hotwolf/AriCalculator/Hardware/RevC/Keypad/KiCad/Keypad4.jpg

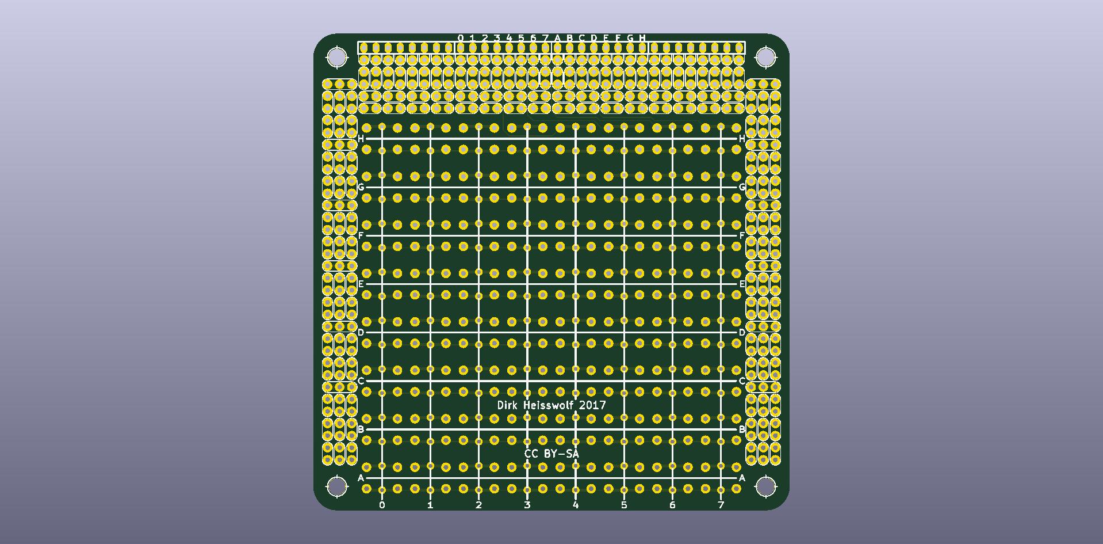
Hardware/RevC/Keypad/KiCad/Keypad4.jpg
