hotwolf/AriCalculator/Hardware/RevC/Keypad/KiCad/Keypad1.jpg

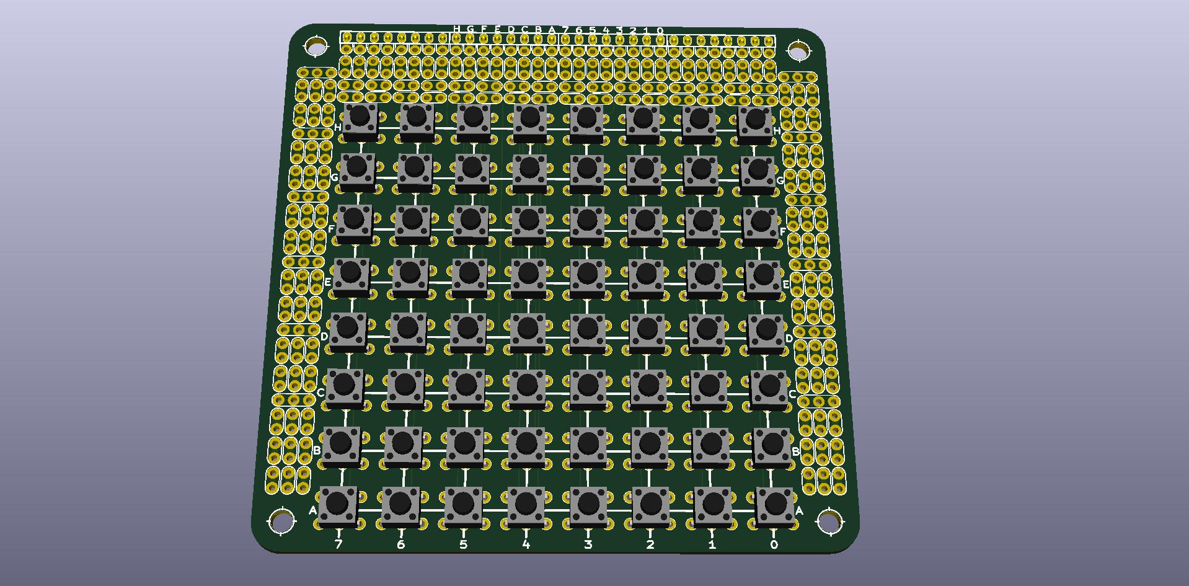
Hardware/RevC/Keypad/KiCad/Keypad1.jpg
