hotwolf/AriCalculator/Hardware/RevC/Keypad/KiCad/Keypad2.jpg

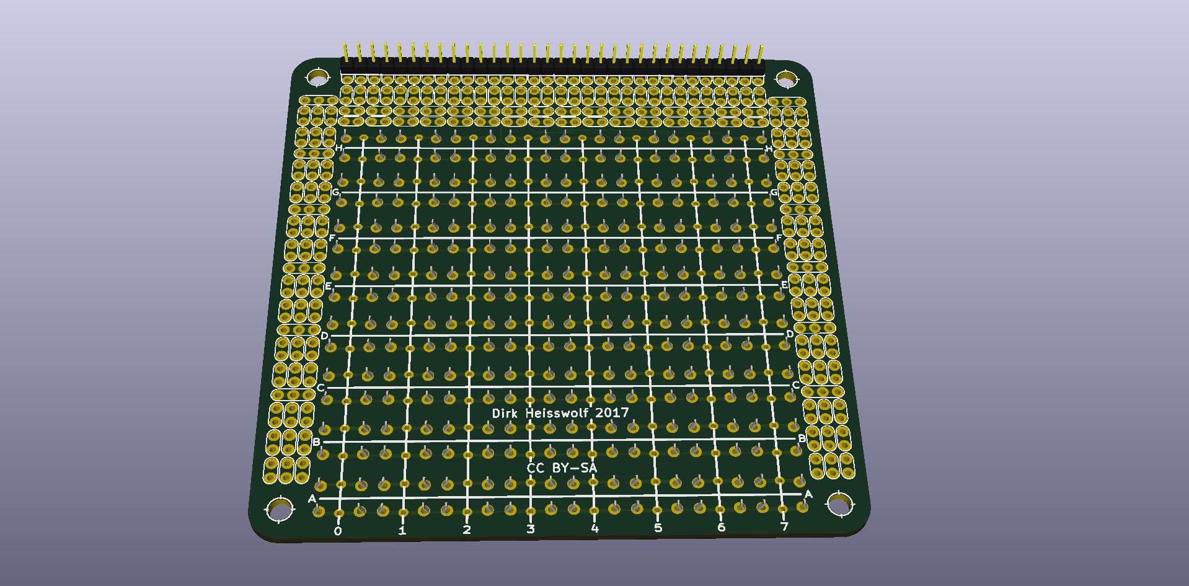
Hardware/RevC/Keypad/KiCad/Keypad2.jpg
