hotwolf/AriCalculator/(list of files, cad)

Other CAD files:
Hardware/RevC/Enclosure/case.scad
