hotwolf/AriCalculator/Hardware/RevC/PCB/AriCalculator-RevC Assembly Plan.pdf

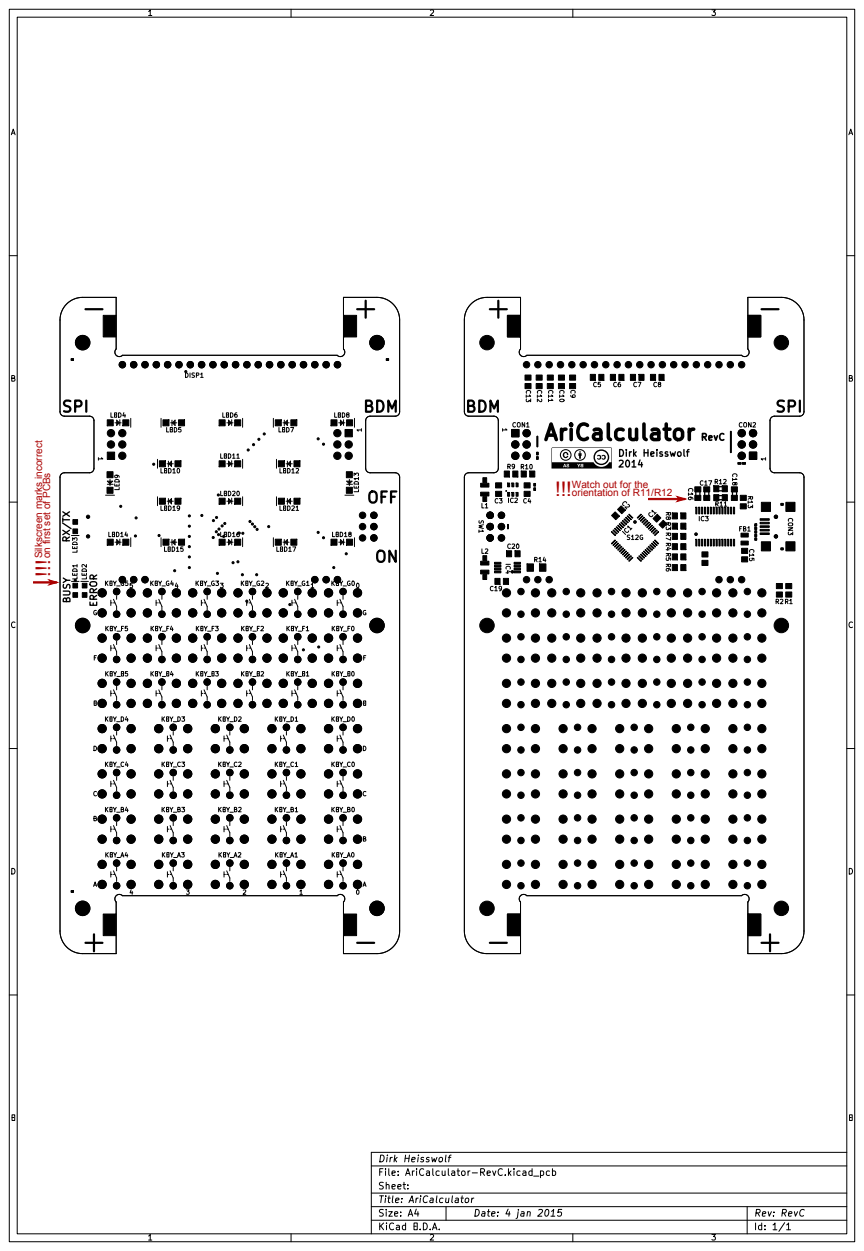
[picture p4: page 1]

Silkscreen marks incorrect

on first set of PCBs !!!

Watch out for the !!!orientation of R11/R12
