hotwolf/AriCalculator/Hardware/RevC/PCB/AriCalculator-RevC Schematic.pdf

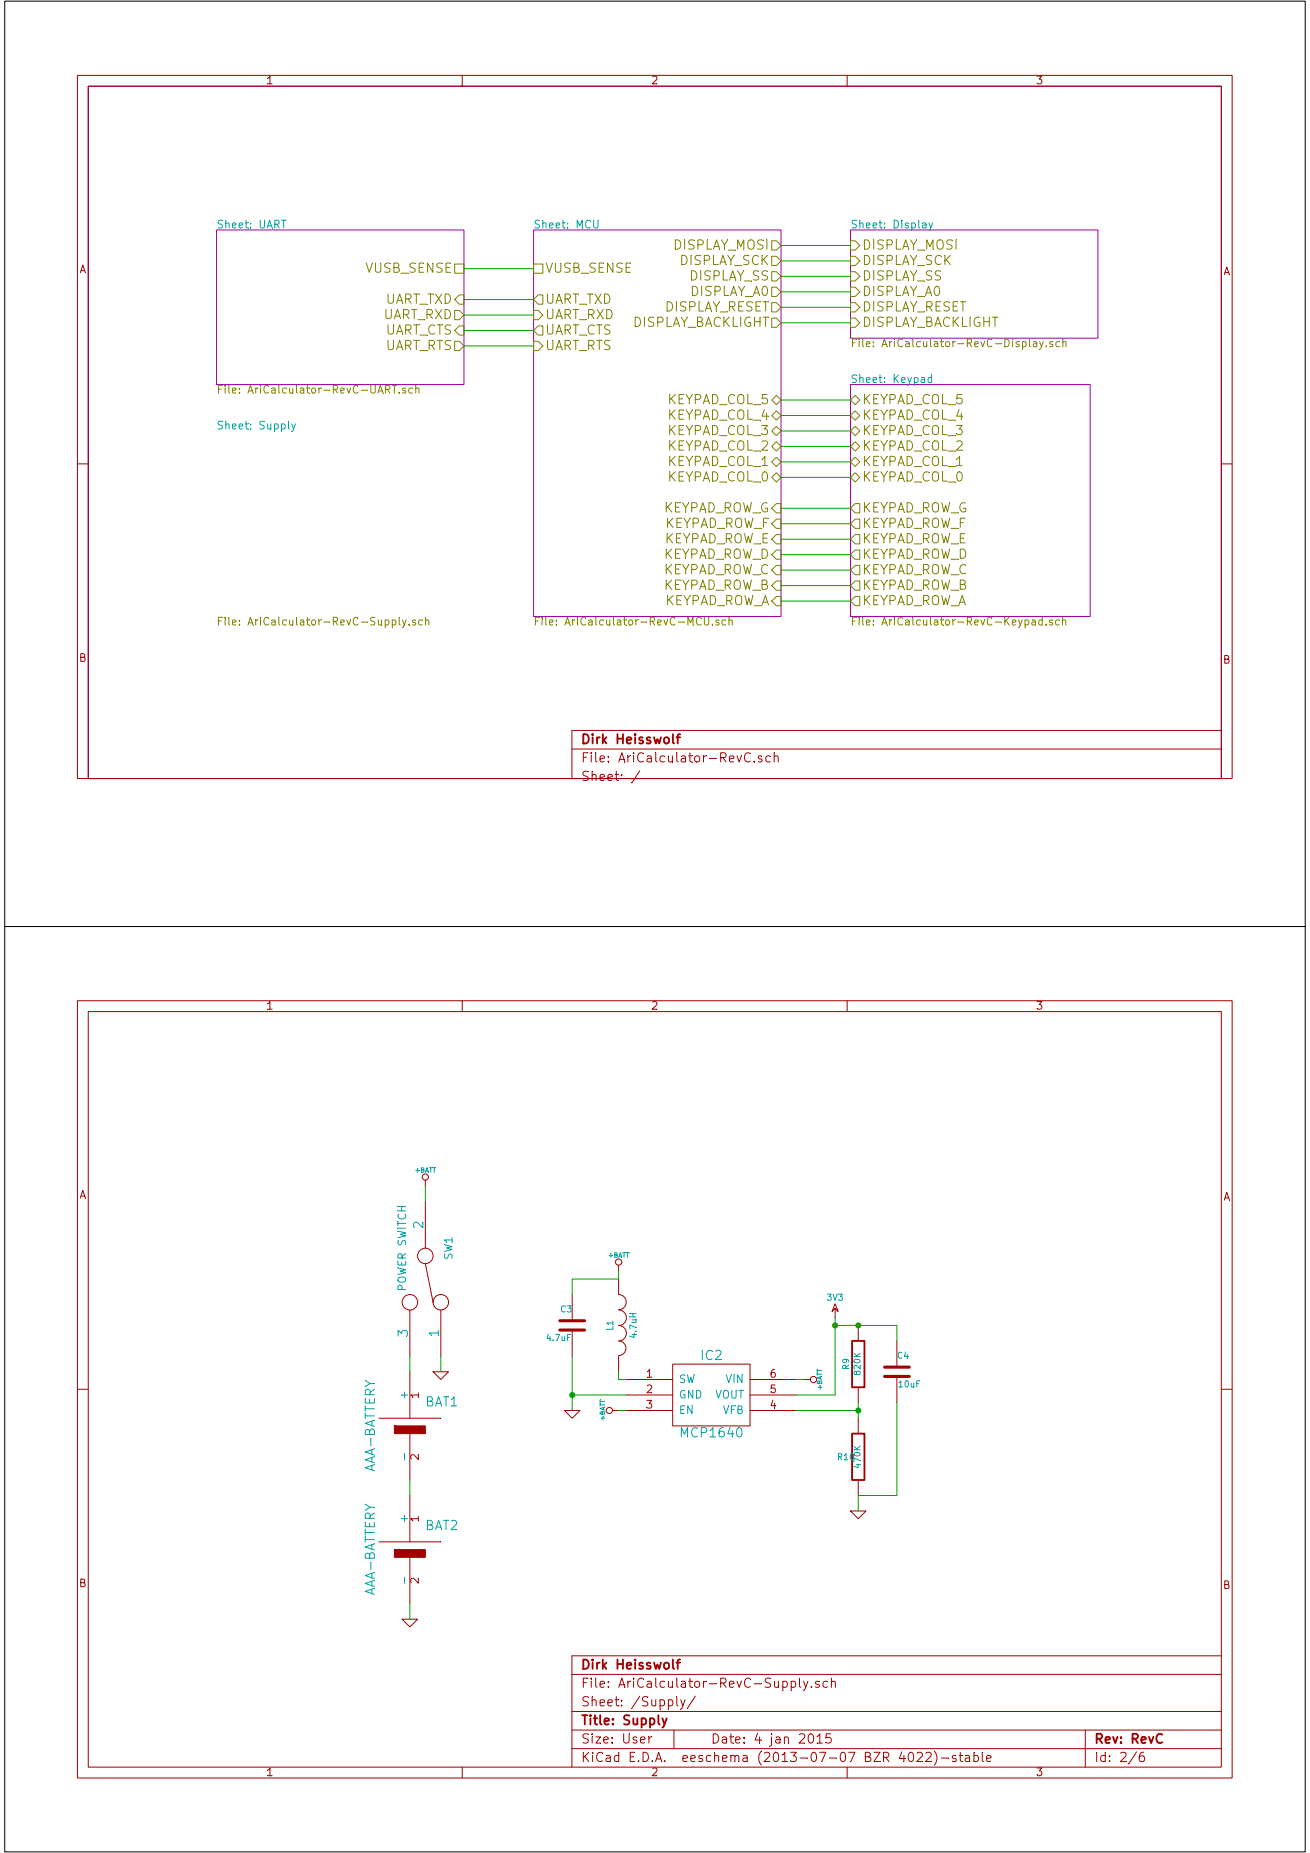
[picture p5: page 1]

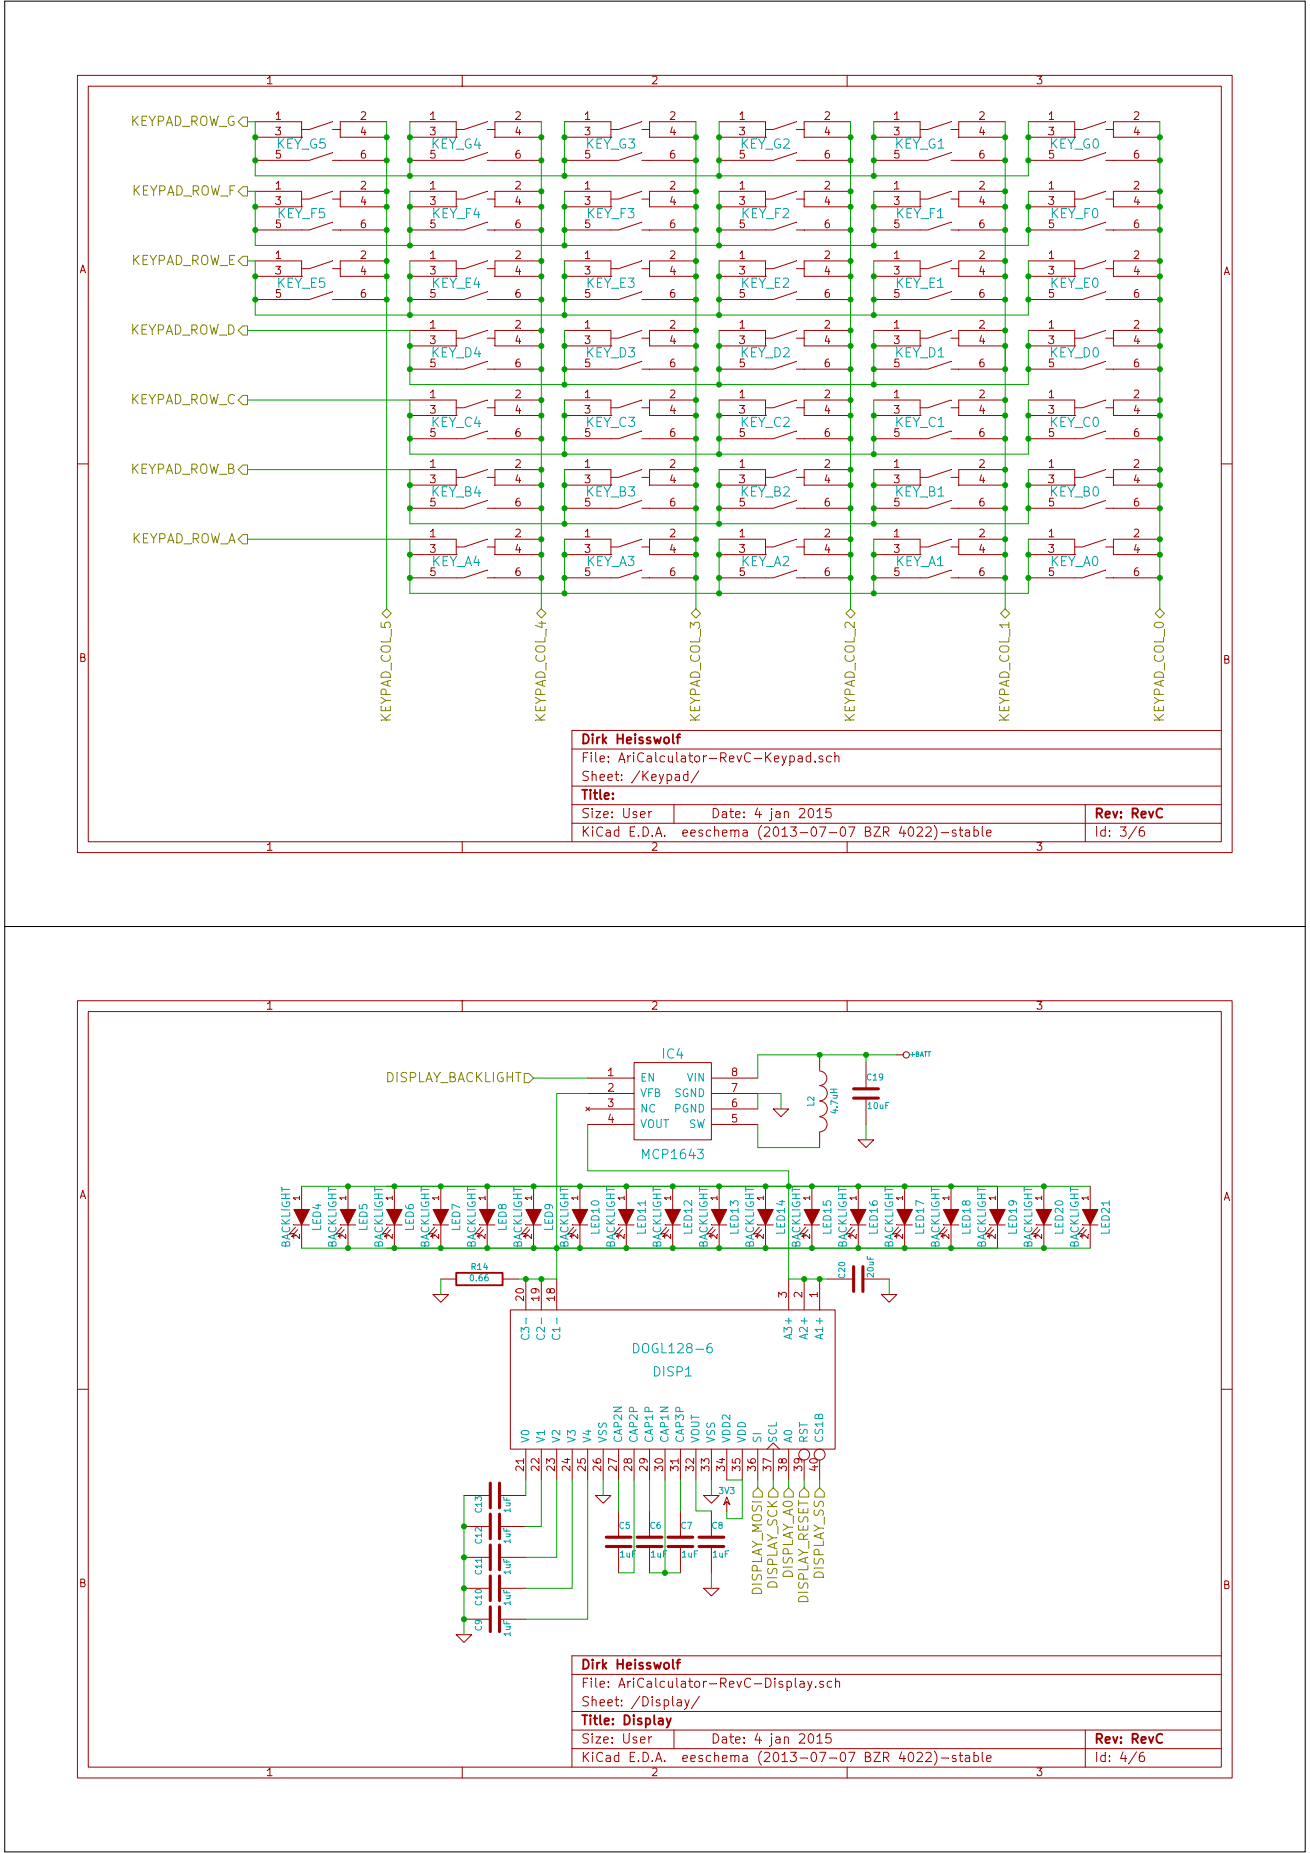
[picture p6: page 2]

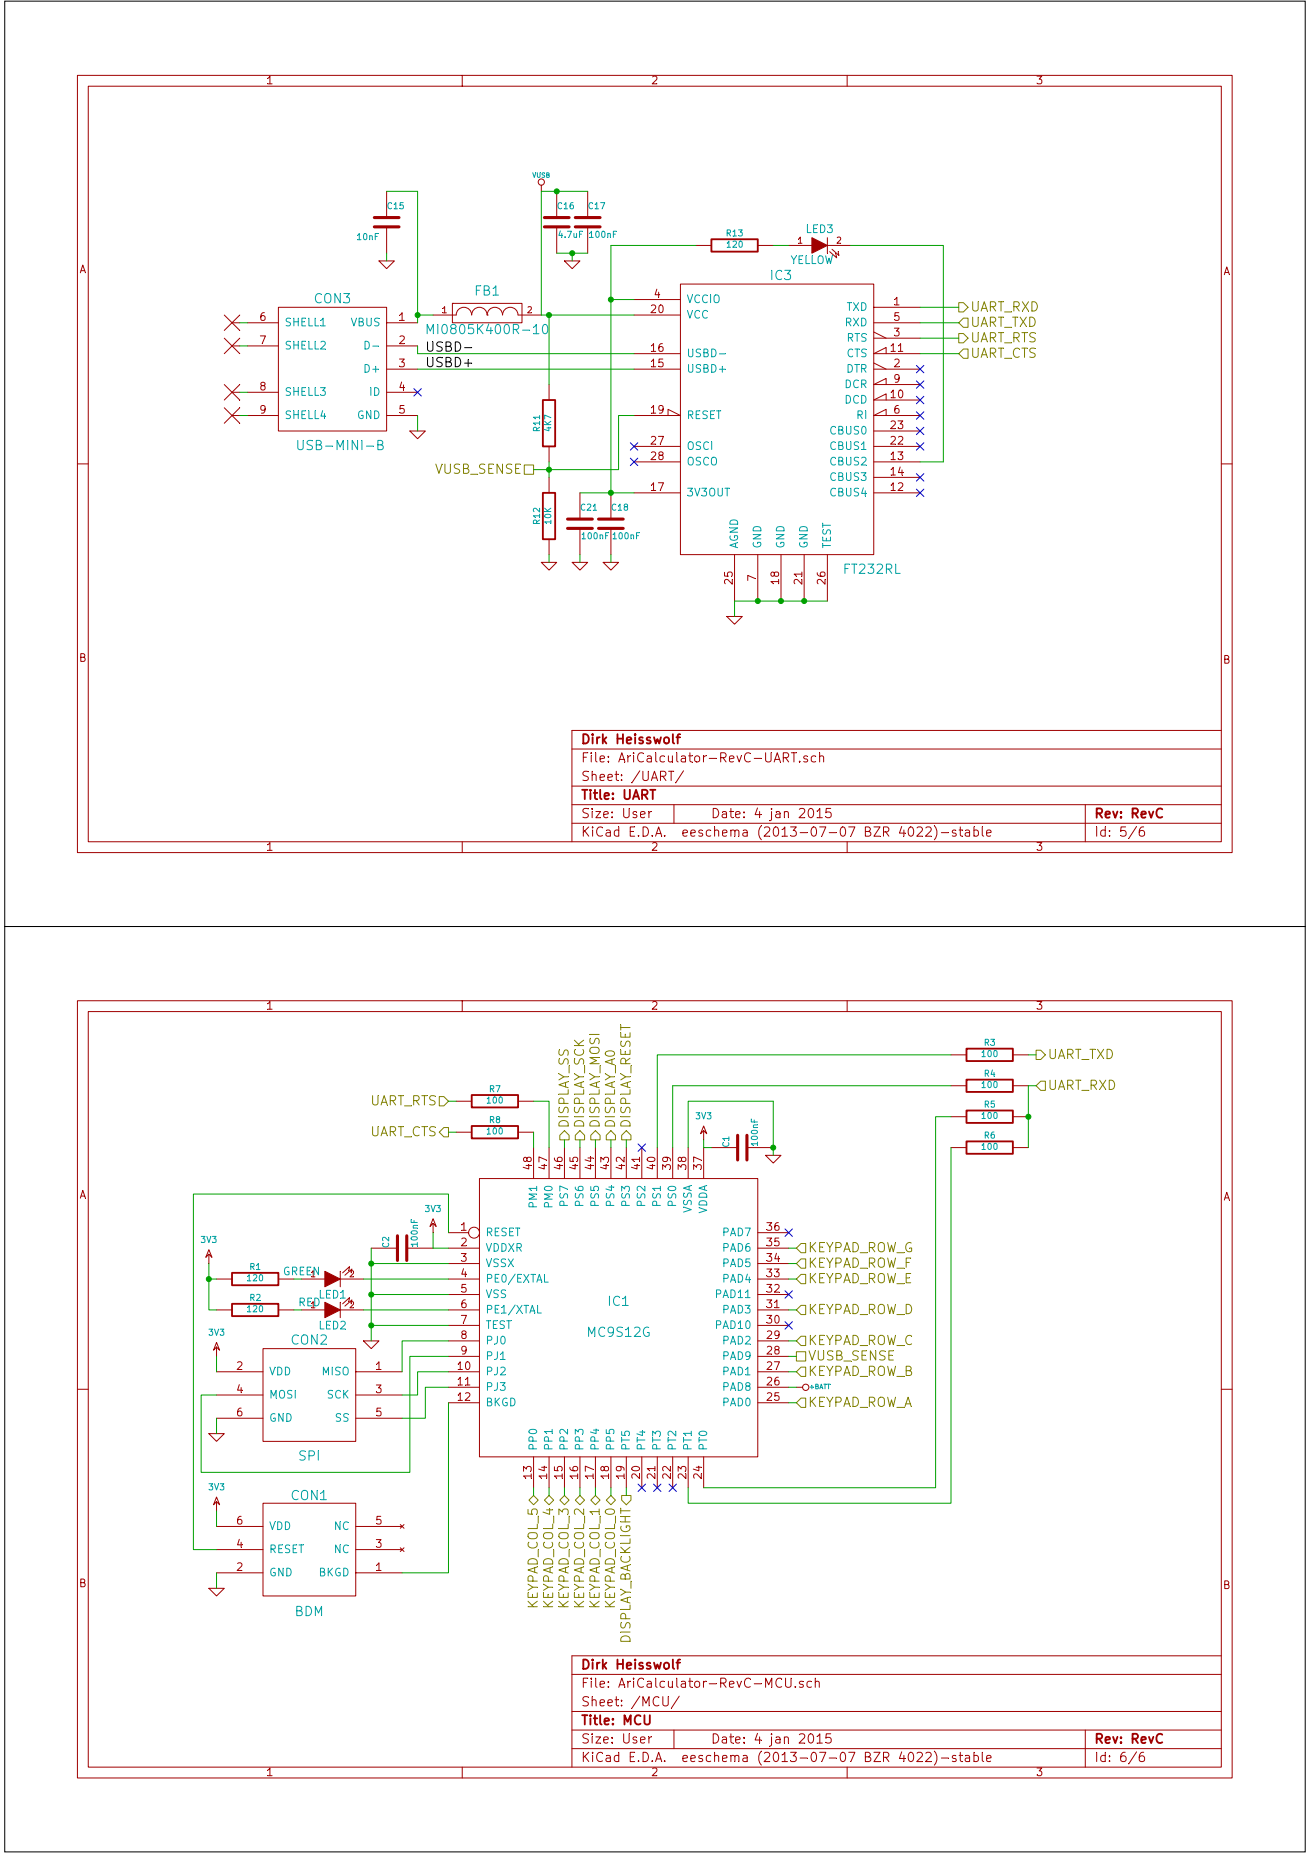
[picture p7: page 3]
