hotwolf/AriCalculator/Hardware/RevC/Enclosure/AriCalculator-RevC Laser Order - Dimensions.pdf

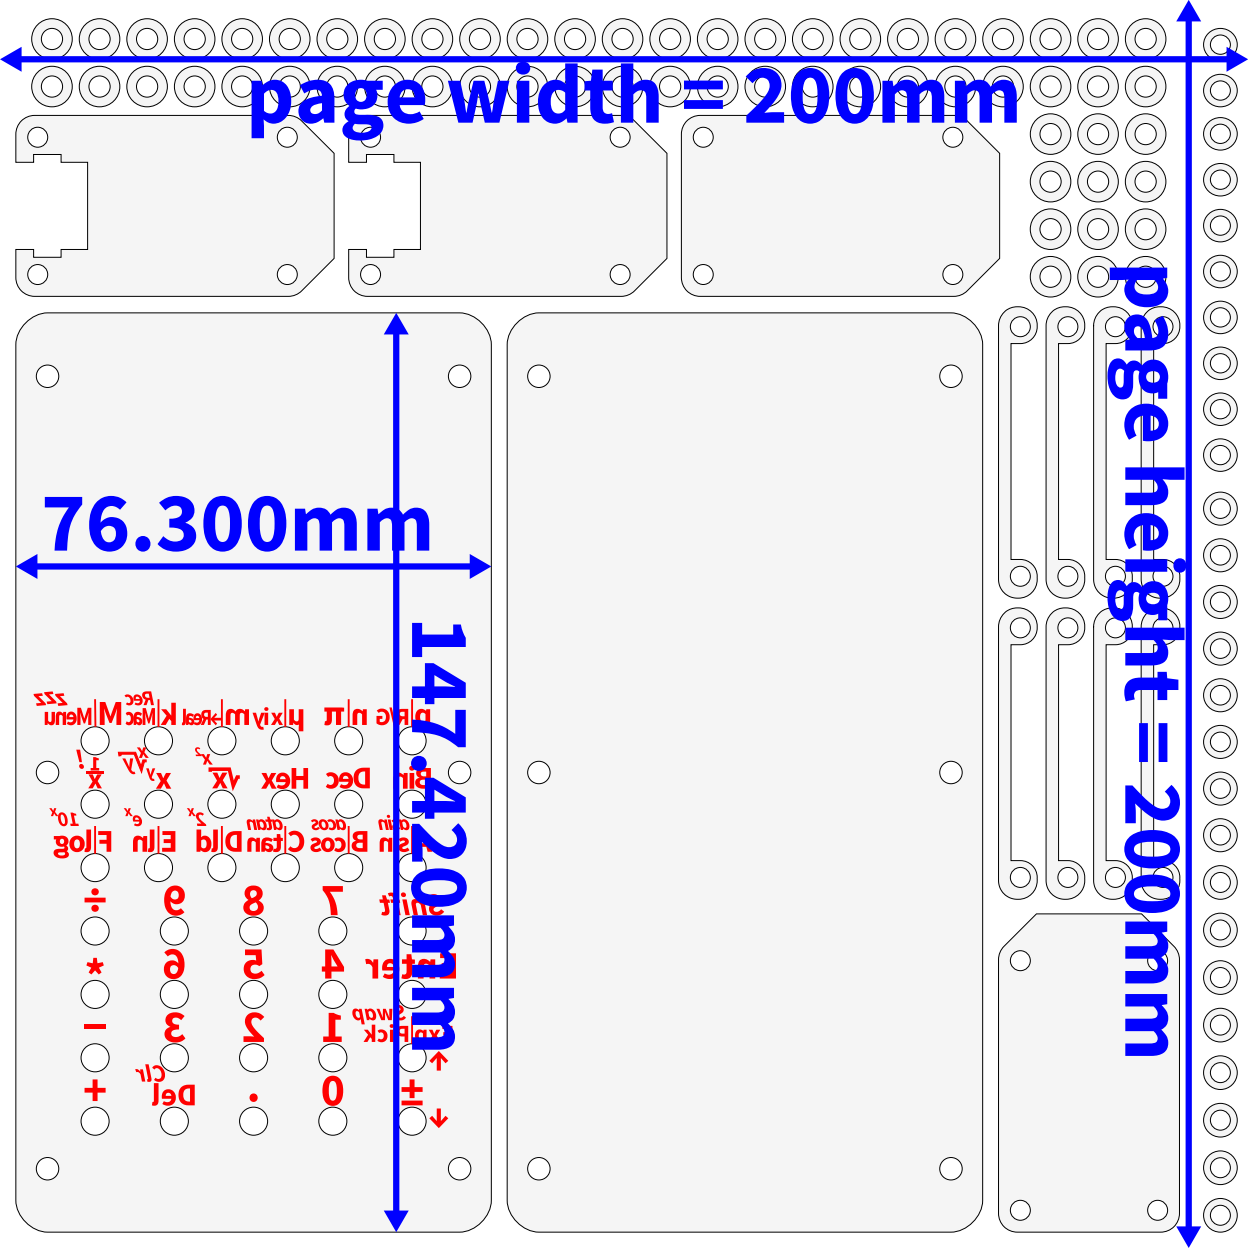
[picture p8: page 1]
