hotwolf/AriCalculator/Hardware/RevC/Keypad/KiCad/Keypad.kicad_pcb

## KiCad design Hardware/RevC/Keypad/KiCad/Keypad.kicad_pcb (2018-02-14)

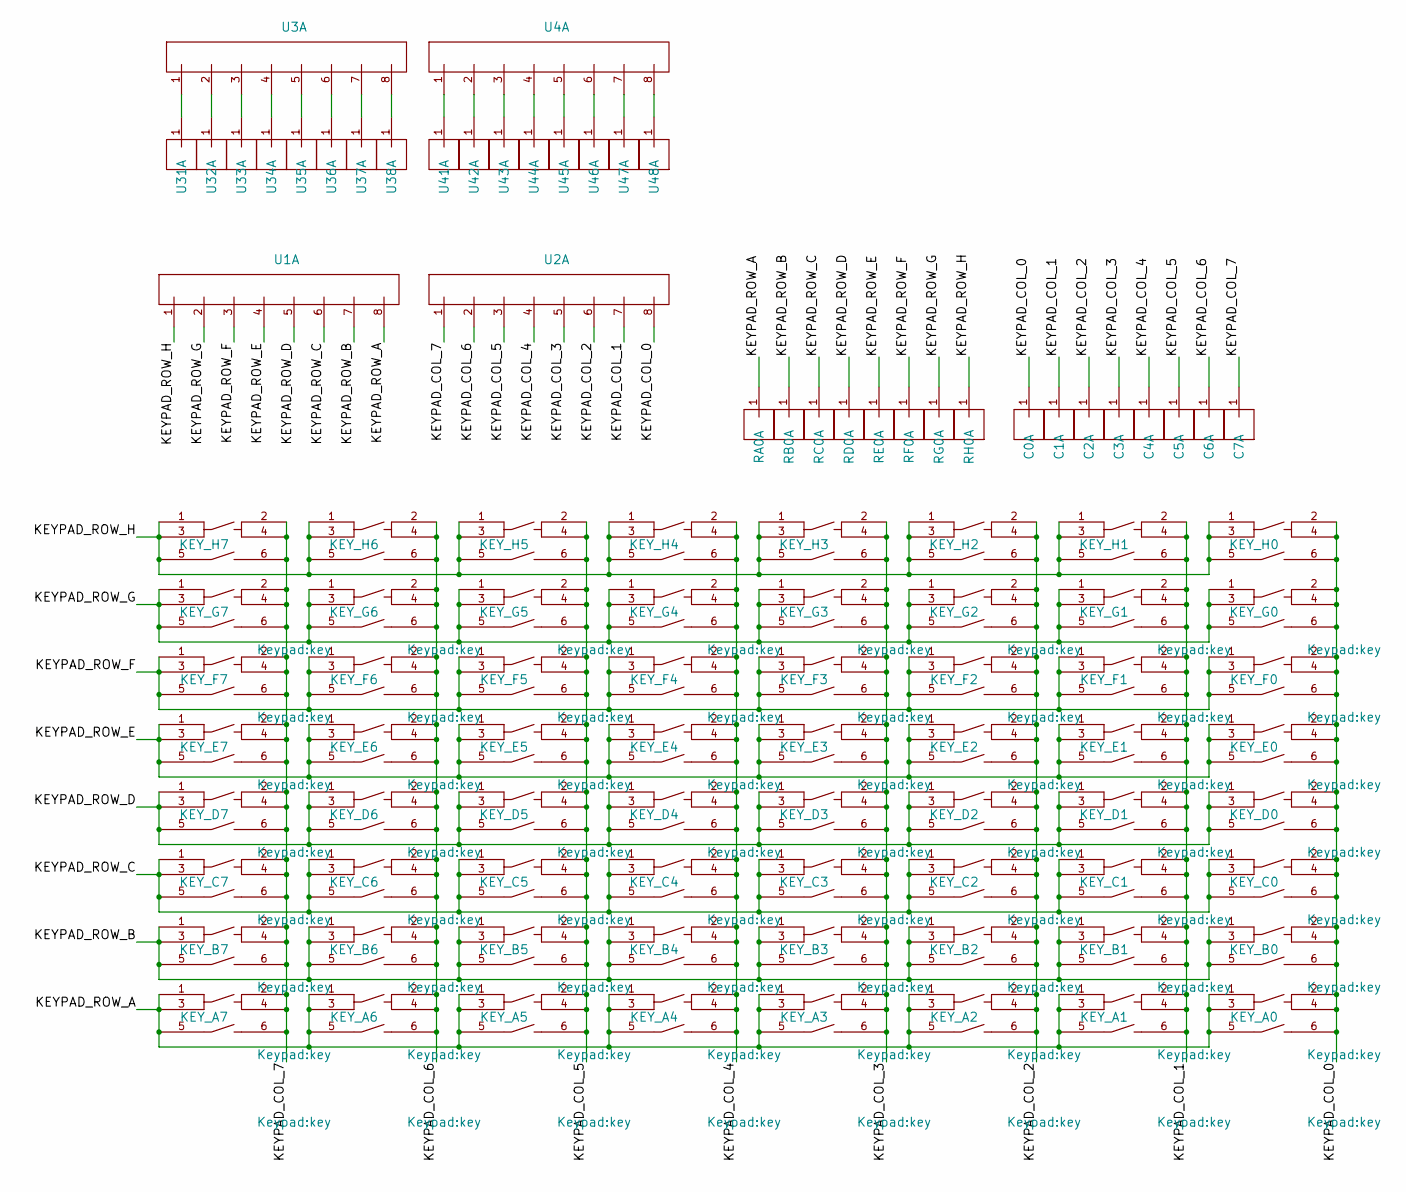
[picture p9: schematic Keypad.sch]

Parts:
C0, C1, C2, C3, C4, C5, C6, C7: PIN_STRIP_1; Connected_Pad
KEY_A0, KEY_A1, KEY_A2, KEY_A3, KEY_A4, KEY_A5, KEY_A6, KEY_A7: KEY; key
KEY_B0, KEY_B1, KEY_B2, KEY_B3, KEY_B4, KEY_B5, KEY_B6, KEY_B7: KEY; key
KEY_C0, KEY_C1, KEY_C2, KEY_C3, KEY_C4, KEY_C5, KEY_C6, KEY_C7: KEY; key
KEY_D0, KEY_D1, KEY_D2, KEY_D3, KEY_D4, KEY_D5, KEY_D6, KEY_D7: KEY; key
KEY_E0, KEY_E1, KEY_E2, KEY_E3, KEY_E4, KEY_E5, KEY_E6, KEY_E7: KEY; key
KEY_F0, KEY_F1, KEY_F2, KEY_F3, KEY_F4, KEY_F5, KEY_F6, KEY_F7: KEY; key
KEY_G0, KEY_G1, KEY_G2, KEY_G3, KEY_G4, KEY_G5, KEY_G6, KEY_G7: KEY; key
KEY_H0, KEY_H1, KEY_H2, KEY_H3, KEY_H4, KEY_H5, KEY_H6, KEY_H7: KEY; key
RA0: PIN_STRIP_1; Connected_Pad
RB0: PIN_STRIP_1; Connected_Pad
RC0: PIN_STRIP_1; Connected_Pad
RD0: PIN_STRIP_1; Connected_Pad
RE0: PIN_STRIP_1; Connected_Pad
RF0: PIN_STRIP_1; Connected_Pad
RG0: PIN_STRIP_1; Connected_Pad
RH0: PIN_STRIP_1; Connected_Pad
U1, U2, U3, U4: PIN_STRIP_8; pin_strip_8
U31, U32, U33, U34, U35, U36, U37, U38, U41, U42, U43, U44, U45, U46, U47, U48: PIN_STRIP_1; Connected_Pad

Connections:
/KEYPAD_COL_0: C0.1, KEY_A0.2, KEY_A0.4, KEY_A0.6, KEY_B0.2, KEY_B0.4, KEY_B0.6, KEY_C0.2, KEY_C0.4, KEY_C0.6, KEY_D0.2, KEY_D0.4, KEY_D0.6, KEY_E0.2, KEY_E0.4, KEY_E0.6, KEY_F0.2, KEY_F0.4, KEY_F0.6, KEY_G0.2, KEY_G0.4, KEY_G0.6, KEY_H0.2, KEY_H0.4, KEY_H0.6, U2.8
/KEYPAD_COL_1: C1.1, KEY_A1.2, KEY_A1.4, KEY_A1.6, KEY_B1.2, KEY_B1.4, KEY_B1.6, KEY_C1.2, KEY_C1.4, KEY_C1.6, KEY_D1.2, KEY_D1.4, KEY_D1.6, KEY_E1.2, KEY_E1.4, KEY_E1.6, KEY_F1.2, KEY_F1.4, KEY_F1.6, KEY_G1.2, KEY_G1.4, KEY_G1.6, KEY_H1.2, KEY_H1.4, KEY_H1.6, U2.7
/KEYPAD_COL_2: C2.1, KEY_A2.2, KEY_A2.4, KEY_A2.6, KEY_B2.2, KEY_B2.4, KEY_B2.6, KEY_C2.2, KEY_C2.4, KEY_C2.6, KEY_D2.2, KEY_D2.4, KEY_D2.6, KEY_E2.2, KEY_E2.4, KEY_E2.6, KEY_F2.2, KEY_F2.4, KEY_F2.6, KEY_G2.2, KEY_G2.4, KEY_G2.6, KEY_H2.2, KEY_H2.4, KEY_H2.6, U2.6
/KEYPAD_COL_3: C3.1, KEY_A3.2, KEY_A3.4, KEY_A3.6, KEY_B3.2, KEY_B3.4, KEY_B3.6, KEY_C3.2, KEY_C3.4, KEY_C3.6, KEY_D3.2, KEY_D3.4, KEY_D3.6, KEY_E3.2, KEY_E3.4, KEY_E3.6, KEY_F3.2, KEY_F3.4, KEY_F3.6, KEY_G3.2, KEY_G3.4, KEY_G3.6, KEY_H3.2, KEY_H3.4, KEY_H3.6, U2.5
/KEYPAD_COL_4: C4.1, KEY_A4.2, KEY_A4.4, KEY_A4.6, KEY_B4.2, KEY_B4.4, KEY_B4.6, KEY_C4.2, KEY_C4.4, KEY_C4.6, KEY_D4.2, KEY_D4.4, KEY_D4.6, KEY_E4.2, KEY_E4.4, KEY_E4.6, KEY_F4.2, KEY_F4.4, KEY_F4.6, KEY_G4.2, KEY_G4.4, KEY_G4.6, KEY_H4.2, KEY_H4.4, KEY_H4.6, U2.4
/KEYPAD_COL_5: C5.1, KEY_A5.2, KEY_A5.4, KEY_A5.6, KEY_B5.2, KEY_B5.4, KEY_B5.6, KEY_C5.2, KEY_C5.4, KEY_C5.6, KEY_D5.2, KEY_D5.4, KEY_D5.6, KEY_E5.2, KEY_E5.4, KEY_E5.6, KEY_F5.2, KEY_F5.4, KEY_F5.6, KEY_G5.2, KEY_G5.4, KEY_G5.6, KEY_H5.2, KEY_H5.4, KEY_H5.6, U2.3
/KEYPAD_COL_6: C6.1, KEY_A6.2, KEY_A6.4, KEY_A6.6, KEY_B6.2, KEY_B6.4, KEY_B6.6, KEY_C6.2, KEY_C6.4, KEY_C6.6, KEY_D6.2, KEY_D6.4, KEY_D6.6, KEY_E6.2, KEY_E6.4, KEY_E6.6, KEY_F6.2, KEY_F6.4, KEY_F6.6, KEY_G6.2, KEY_G6.4, KEY_G6.6, KEY_H6.2, KEY_H6.4, KEY_H6.6, U2.2
/KEYPAD_COL_7: C7.1, KEY_A7.2, KEY_A7.4, KEY_A7.6, KEY_B7.2, KEY_B7.4, KEY_B7.6, KEY_C7.2, KEY_C7.4, KEY_C7.6, KEY_D7.2, KEY_D7.4, KEY_D7.6, KEY_E7.2, KEY_E7.4, KEY_E7.6, KEY_F7.2, KEY_F7.4, KEY_F7.6, KEY_G7.2, KEY_G7.4, KEY_G7.6, KEY_H7.2, KEY_H7.4, KEY_H7.6, U2.1
/KEYPAD_ROW_A: KEY_A0.1, KEY_A0.3, KEY_A0.5, KEY_A1.1, KEY_A1.3, KEY_A1.5, KEY_A2.1, KEY_A2.3, KEY_A2.5, KEY_A3.1, KEY_A3.3, KEY_A3.5, KEY_A4.1, KEY_A4.3, KEY_A4.5, KEY_A5.1, KEY_A5.3, KEY_A5.5, KEY_A6.1, KEY_A6.3, KEY_A6.5, KEY_A7.1, KEY_A7.3, KEY_A7.5, RA0.1, U1.8
/KEYPAD_ROW_B: KEY_B0.1, KEY_B0.3, KEY_B0.5, KEY_B1.1, KEY_B1.3, KEY_B1.5, KEY_B2.1, KEY_B2.3, KEY_B2.5, KEY_B3.1, KEY_B3.3, KEY_B3.5, KEY_B4.1, KEY_B4.3, KEY_B4.5, KEY_B5.1, KEY_B5.3, KEY_B5.5, KEY_B6.1, KEY_B6.3, KEY_B6.5, KEY_B7.1, KEY_B7.3, KEY_B7.5, RB0.1, U1.7
/KEYPAD_ROW_C: KEY_C0.1, KEY_C0.3, KEY_C0.5, KEY_C1.1, KEY_C1.3, KEY_C1.5, KEY_C2.1, KEY_C2.3, KEY_C2.5, KEY_C3.1, KEY_C3.3, KEY_C3.5, KEY_C4.1, KEY_C4.3, KEY_C4.5, KEY_C5.1, KEY_C5.3, KEY_C5.5, KEY_C6.1, KEY_C6.3, KEY_C6.5, KEY_C7.1, KEY_C7.3, KEY_C7.5, RC0.1, U1.6
/KEYPAD_ROW_D: KEY_D0.1, KEY_D0.3, KEY_D0.5, KEY_D1.1, KEY_D1.3, KEY_D1.5, KEY_D2.1, KEY_D2.3, KEY_D2.5, KEY_D3.1, KEY_D3.3, KEY_D3.5, KEY_D4.1, KEY_D4.3, KEY_D4.5, KEY_D5.1, KEY_D5.3, KEY_D5.5, KEY_D6.1, KEY_D6.3, KEY_D6.5, KEY_D7.1, KEY_D7.3, KEY_D7.5, RD0.1, U1.5
/KEYPAD_ROW_E: KEY_E0.1, KEY_E0.3, KEY_E0.5, KEY_E1.1, KEY_E1.3, KEY_E1.5, KEY_E2.1, KEY_E2.3, KEY_E2.5, KEY_E3.1, KEY_E3.3, KEY_E3.5, KEY_E4.1, KEY_E4.3, KEY_E4.5, KEY_E5.1, KEY_E5.3, KEY_E5.5, KEY_E6.1, KEY_E6.3, KEY_E6.5, KEY_E7.1, KEY_E7.3, KEY_E7.5, RE0.1, U1.4
/KEYPAD_ROW_F: KEY_F0.1, KEY_F0.3, KEY_F0.5, KEY_F1.1, KEY_F1.3, KEY_F1.5, KEY_F2.1, KEY_F2.3, KEY_F2.5, KEY_F3.1, KEY_F3.3, KEY_F3.5, KEY_F4.1, KEY_F4.3, KEY_F4.5, KEY_F5.1, KEY_F5.3, KEY_F5.5, KEY_F6.1, KEY_F6.3, KEY_F6.5, KEY_F7.1, KEY_F7.3, KEY_F7.5, RF0.1, U1.3
/KEYPAD_ROW_G: KEY_G0.1, KEY_G0.3, KEY_G0.5, KEY_G1.1, KEY_G1.3, KEY_G1.5, KEY_G2.1, KEY_G2.3, KEY_G2.5, KEY_G3.1, KEY_G3.3, KEY_G3.5, KEY_G4.1, KEY_G4.3, KEY_G4.5, KEY_G5.1, KEY_G5.3, KEY_G5.5, KEY_G6.1, KEY_G6.3, KEY_G6.5, KEY_G7.1, KEY_G7.3, KEY_G7.5, RG0.1, U1.2
/KEYPAD_ROW_H: KEY_H0.1, KEY_H0.3, KEY_H0.5, KEY_H1.1, KEY_H1.3, KEY_H1.5, KEY_H2.1, KEY_H2.3, KEY_H2.5, KEY_H3.1, KEY_H3.3, KEY_H3.5, KEY_H4.1, KEY_H4.3, KEY_H4.5, KEY_H5.1, KEY_H5.3, KEY_H5.5, KEY_H6.1, KEY_H6.3, KEY_H6.5, KEY_H7.1, KEY_H7.3, KEY_H7.5, RH0.1, U1.1
unnamed: U3.1, U31.1
unnamed: U3.2, U32.1
unnamed: U3.3, U33.1
unnamed: U3.4, U34.1
unnamed: U3.5, U35.1
unnamed: U3.6, U36.1
unnamed: U3.7, U37.1
unnamed: U3.8, U38.1
unnamed: U4.1, U41.1
unnamed: U4.2, U42.1
unnamed: U4.3, U43.1
unnamed: U4.4, U44.1
unnamed: U4.5, U45.1
unnamed: U4.6, U46.1
unnamed: U4.7, U47.1
unnamed: U4.8, U48.1

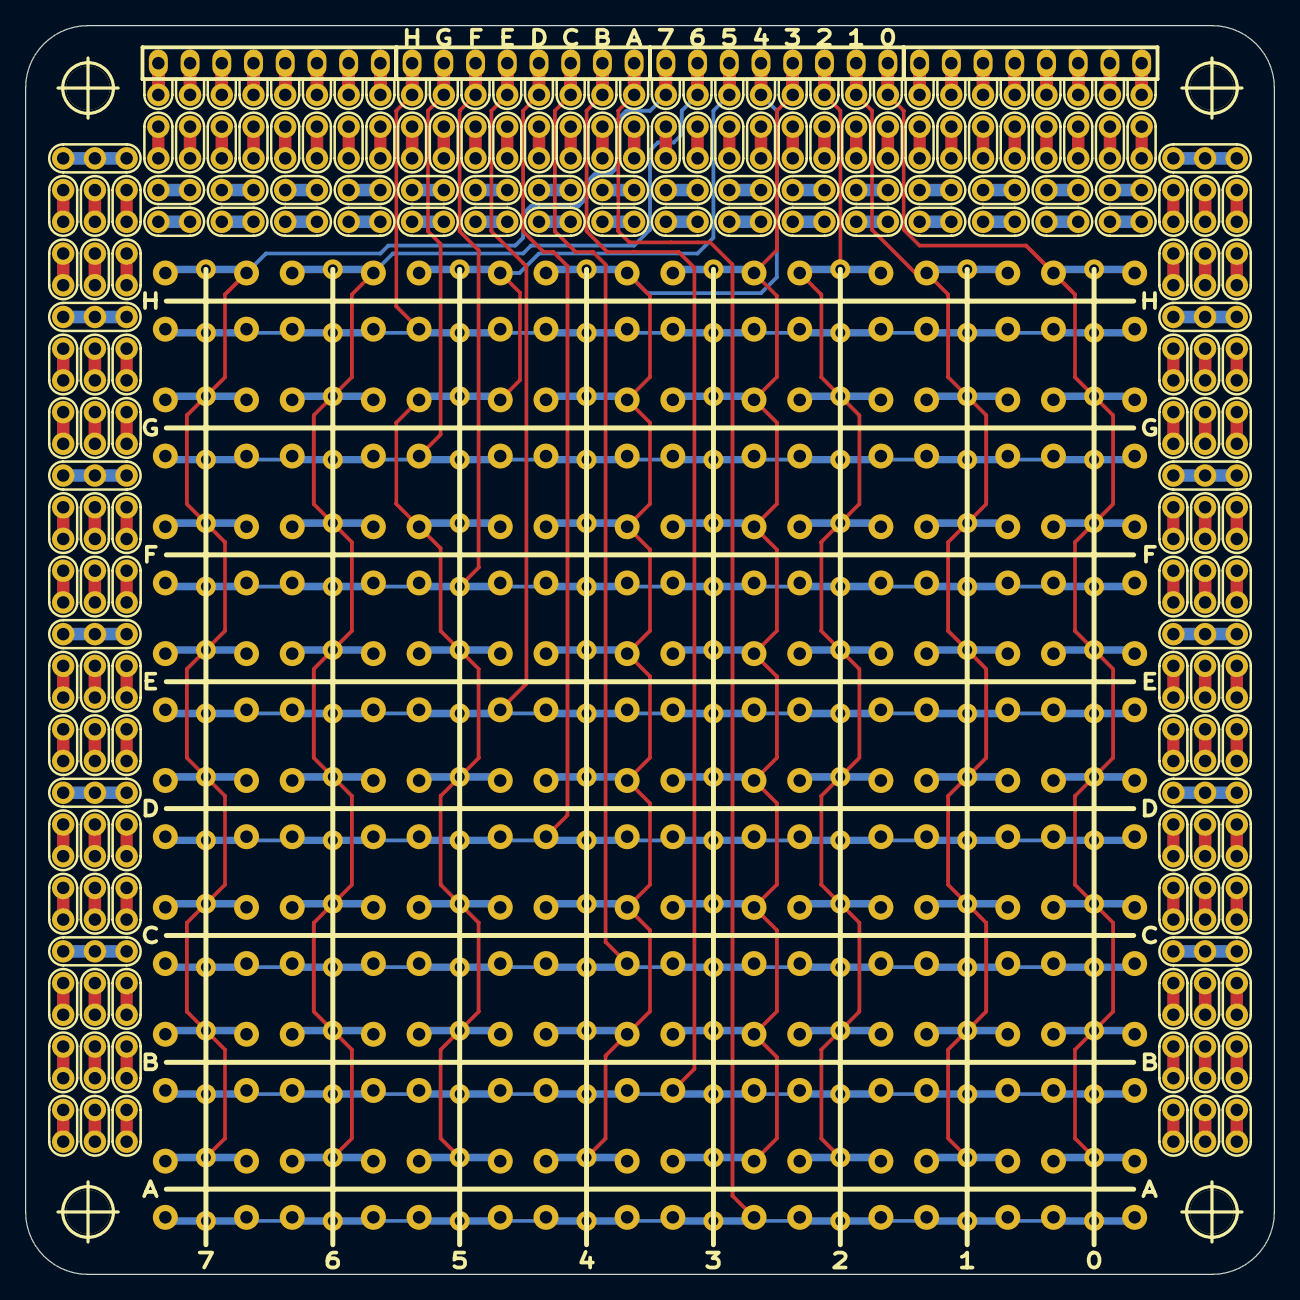
[picture p10: board Keypad.kicad_pcb from above]

Board: 2 copper layers, 100.0 x 100.0 mm, 104 parts (0 on the bottom side), 32 nets.

Other parts of the board:
hole_3mm5, hole_3mm5#2, hole_3mm5#3, hole_3mm5#4: VAL**; hole_3mm5
