hotwolf/AriCalculator/Hardware/RevC/AriCalculator-RevC.kicad_pcb

## KiCad design Hardware/RevC/AriCalculator-RevC.kicad_pcb (2014-12-04)

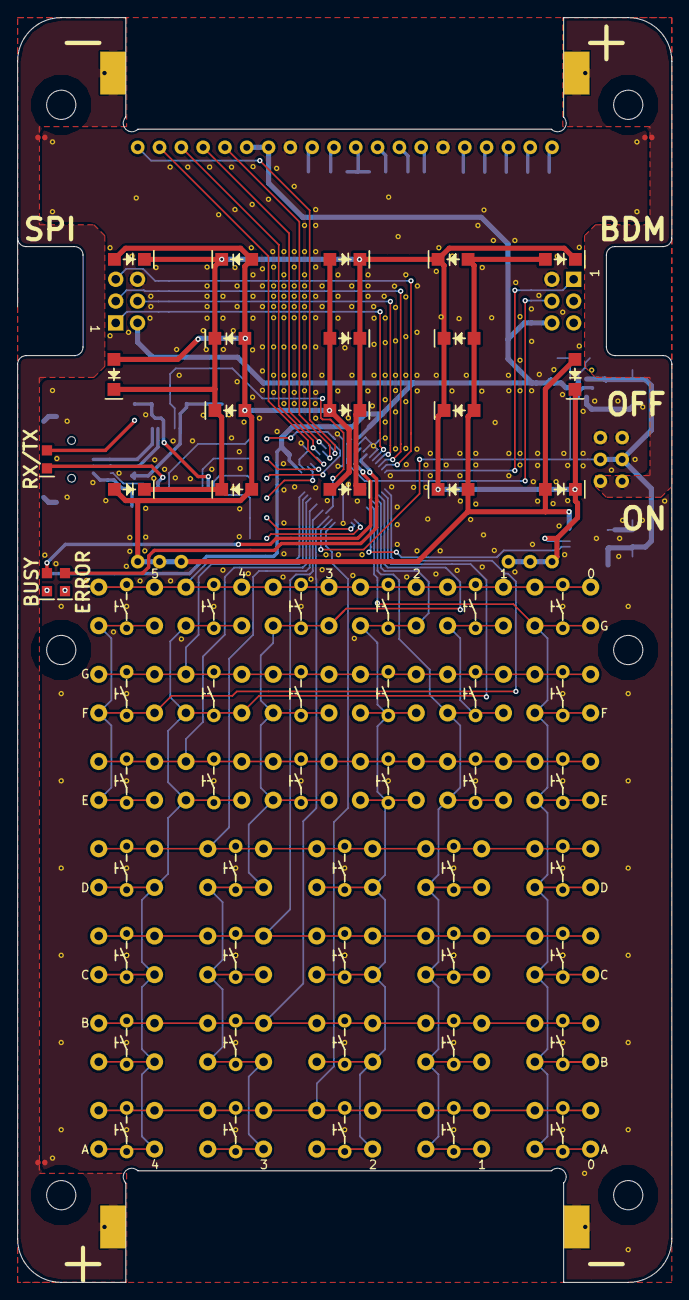
[picture p11: board AriCalculator-RevC.kicad_pcb from above]

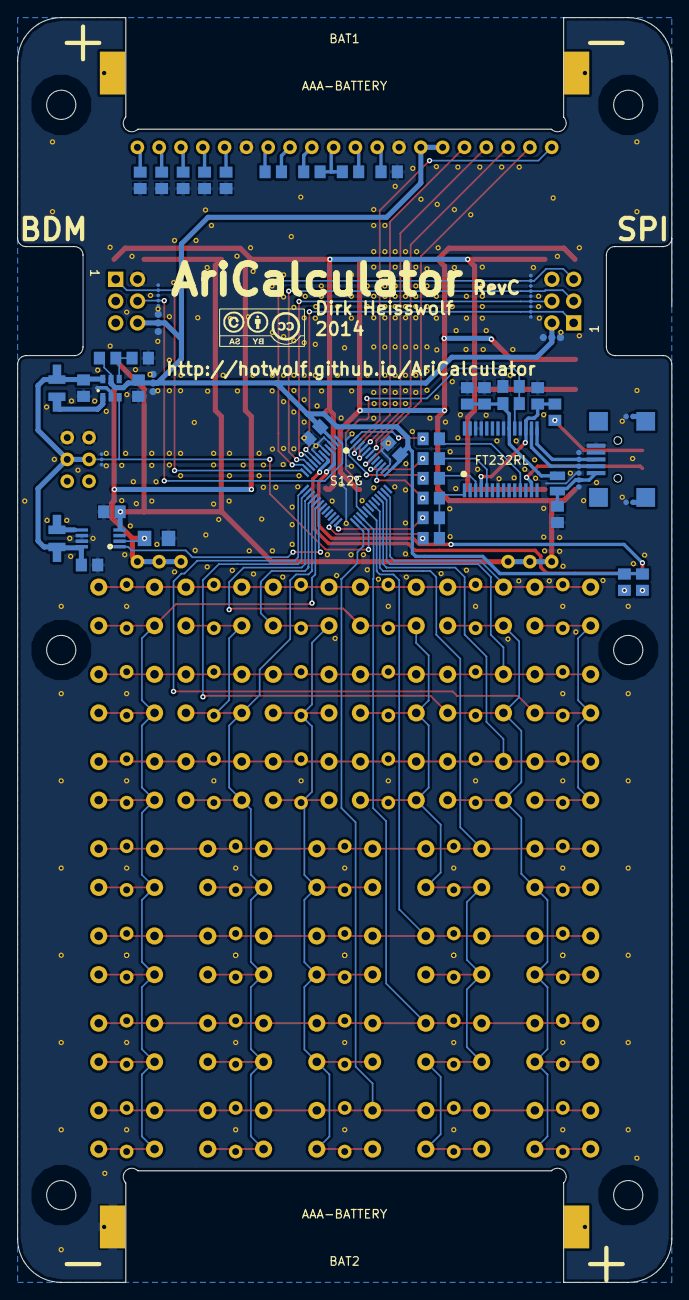
[picture p12: board AriCalculator-RevC.kicad_pcb from below]

Board: 2 copper layers, 76.2 x 147.3 mm, 149 parts (82 on the bottom side), 68 nets.

Parts:
BAT1, BAT2: AAA-BATTERY; AAA-battery
C1: 100nf; c_0805
C2, C17, C18: 100nF; c_0805
C3, C16: 4.7uF; c_0805
C4, C19: 10uF; c_0805
C5, C6, C7, C8, C9, C10, C11, C12, C13: 1uF; c_0805
C15: 10nF; c_0805
C20: 20uF; c_0805
CON1: BDM; pin_strip_3x2-90
CON2: SPI; pin_strip_3x2-90
CON3: USB-MINI-B; conn_usb_B_mini_smd
DISP1: DOGL128-6; dogl128-6
FB1: MI0805K400R-10; inductor_smd_0805
IC1: MC9S12G; lqfp48
IC2: MCP1640; sot23-6
IC3: FT232RL; ssop-28
IC4: MCP1643; msop-8
KEY_A0, KEY_A1, KEY_A2, KEY_A3, KEY_A4: KEY; key
KEY_B0, KEY_B1, KEY_B2, KEY_B3, KEY_B4: KEY; key
KEY_C0, KEY_C1, KEY_C2, KEY_C3, KEY_C4: KEY; key
KEY_D0, KEY_D1, KEY_D2, KEY_D3, KEY_D4: KEY; key
KEY_E0, KEY_E1, KEY_E2, KEY_E3, KEY_E4, KEY_E5: KEY; key
KEY_F0, KEY_F1, KEY_F2, KEY_F3, KEY_F4, KEY_F5: KEY; key
KEY_G0, KEY_G1, KEY_G2, KEY_G3, KEY_G4, KEY_G5: KEY; key
L1, L2: 4.7uH; lqh3c
LED1: GREEN; led_0805
LED2: RED; led_0805
LED3: YELLOW; led_0805
LED4, LED5, LED6, LED7, LED8, LED9, LED10, LED11, LED12, LED13, LED14, LED15, LED16, LED17, LED18, LED19, LED20, LED21: BACKLIGHT; led_1206
R1, R2, R13: 120; r_0805
R3, R4, R5, R6, R7, R8: 100; r_0805
R9: 820K; r_0805
R10: 470K; r_0805
R11: 4K7; r_0805
R12: 10K; r_0805
R14: 0.66; r_1206
SG: 0.8; spark_gap_pad_0.8
SG#2, SG#3, SG#4, SG#5, SG#6, SG#7, SG#8, SG#9, SG#10, SG#11, SG#12: 0.8; spark_gap_pad_0.8
SG#13, SG#14, SG#15, SG#16, SG#17, SG#18, SG#19, SG#20, SG#21: 1.0; spark_gap_pad_1.0
SG#22, SG#23, SG#24, SG#25, SG#26, SG#27, SG#28, SG#29, SG#30, SG#31, SG#32, SG#33, SG#34, SG#35, SG#36, SG#37, SG#38: 0.6; spark_gap_pad_0.6
SW1: POWER SWITCH; switch
enclosure: AriCalculator; enclosure
spark_gap_pad_0.8, spark_gap_pad_0.8#2, spark_gap_pad_0.8#3, spark_gap_pad_0.8#4: SG; spark_gap_pad_0.8

Connections:
3V3: C1.1, C2.2, C4.1, CON1.6, CON2.2, DISP1.34, DISP1.35, IC1.2, IC1.37, IC2.5, R1.1, R2.1, R9.1
+BATT: C3.1, C19.1, IC1.26, IC2.3, IC2.6, IC4.8, L1.2, L2.1, SW1.2
/Display/DISPLAY_A0: DISP1.38, IC1.43
/Display/DISPLAY_BACKLIGHT: IC1.19, IC4.1
/Display/DISPLAY_MOSI: DISP1.36, IC1.44
/Display/DISPLAY_RESET: DISP1.39, IC1.42
/Display/DISPLAY_SCK: DISP1.37, IC1.45
/Display/DISPLAY_SS: DISP1.40, IC1.46
/Keypad/KEYPAD_COL_0: IC1.18, KEY_A0.2, KEY_A0.4, KEY_A0.6, KEY_B0.2, KEY_B0.4, KEY_B0.6, KEY_C0.2, KEY_C0.4, KEY_C0.6, KEY_D0.2, KEY_D0.4, KEY_D0.6, KEY_E0.2, KEY_E0.4, KEY_E0.6, KEY_F0.2, KEY_F0.4, KEY_F0.6, KEY_G0.2, KEY_G0.4, KEY_G0.6
/Keypad/KEYPAD_COL_1: IC1.17, KEY_A1.2, KEY_A1.4, KEY_A1.6, KEY_B1.2, KEY_B1.4, KEY_B1.6, KEY_C1.2, KEY_C1.4, KEY_C1.6, KEY_D1.2, KEY_D1.4, KEY_D1.6, KEY_E1.2, KEY_E1.4, KEY_E1.6, KEY_F1.2, KEY_F1.4, KEY_F1.6, KEY_G1.2, KEY_G1.4, KEY_G1.6
/Keypad/KEYPAD_COL_2: IC1.16, KEY_A2.2, KEY_A2.4, KEY_A2.6, KEY_B2.2, KEY_B2.4, KEY_B2.6, KEY_C2.2, KEY_C2.4, KEY_C2.6, KEY_D2.2, KEY_D2.4, KEY_D2.6, KEY_E2.2, KEY_E2.4, KEY_E2.6, KEY_F2.2, KEY_F2.4, KEY_F2.6, KEY_G2.2, KEY_G2.4, KEY_G2.6
/Keypad/KEYPAD_COL_3: IC1.15, KEY_A3.2, KEY_A3.4, KEY_A3.6, KEY_B3.2, KEY_B3.4, KEY_B3.6, KEY_C3.2, KEY_C3.4, KEY_C3.6, KEY_D3.2, KEY_D3.4, KEY_D3.6, KEY_E3.2, KEY_E3.4, KEY_E3.6, KEY_F3.2, KEY_F3.4, KEY_F3.6, KEY_G3.2, KEY_G3.4, KEY_G3.6
/Keypad/KEYPAD_COL_4: IC1.14, KEY_A4.2, KEY_A4.4, KEY_A4.6, KEY_B4.2, KEY_B4.4, KEY_B4.6, KEY_C4.2, KEY_C4.4, KEY_C4.6, KEY_D4.2, KEY_D4.4, KEY_D4.6, KEY_E4.2, KEY_E4.4, KEY_E4.6, KEY_F4.2, KEY_F4.4, KEY_F4.6, KEY_G4.2, KEY_G4.4, KEY_G4.6
/Keypad/KEYPAD_COL_5: IC1.13, KEY_E5.2, KEY_E5.4, KEY_E5.6, KEY_F5.2, KEY_F5.4, KEY_F5.6, KEY_G5.2, KEY_G5.4, KEY_G5.6
/Keypad/KEYPAD_ROW_A: IC1.25, KEY_A0.1, KEY_A0.3, KEY_A0.5, KEY_A1.1, KEY_A1.3, KEY_A1.5, KEY_A2.1, KEY_A2.3, KEY_A2.5, KEY_A3.1, KEY_A3.3, KEY_A3.5, KEY_A4.1, KEY_A4.3, KEY_A4.5
/Keypad/KEYPAD_ROW_B: IC1.27, KEY_B0.1, KEY_B0.3, KEY_B0.5, KEY_B1.1, KEY_B1.3, KEY_B1.5, KEY_B2.1, KEY_B2.3, KEY_B2.5, KEY_B3.1, KEY_B3.3, KEY_B3.5, KEY_B4.1, KEY_B4.3, KEY_B4.5
/Keypad/KEYPAD_ROW_C: IC1.29, KEY_C0.1, KEY_C0.3, KEY_C0.5, KEY_C1.1, KEY_C1.3, KEY_C1.5, KEY_C2.1, KEY_C2.3, KEY_C2.5, KEY_C3.1, KEY_C3.3, KEY_C3.5, KEY_C4.1, KEY_C4.3, KEY_C4.5
/Keypad/KEYPAD_ROW_D: IC1.31, KEY_D0.1, KEY_D0.3, KEY_D0.5, KEY_D1.1, KEY_D1.3, KEY_D1.5, KEY_D2.1, KEY_D2.3, KEY_D2.5, KEY_D3.1, KEY_D3.3, KEY_D3.5, KEY_D4.1, KEY_D4.3, KEY_D4.5
/Keypad/KEYPAD_ROW_E: IC1.33, KEY_E0.1, KEY_E0.3, KEY_E0.5, KEY_E1.1, KEY_E1.3, KEY_E1.5, KEY_E2.1, KEY_E2.3, KEY_E2.5, KEY_E3.1, KEY_E3.3, KEY_E3.5, KEY_E4.1, KEY_E4.3, KEY_E4.5, KEY_E5.1, KEY_E5.3, KEY_E5.5
/Keypad/KEYPAD_ROW_F: IC1.34, KEY_F0.1, KEY_F0.3, KEY_F0.5, KEY_F1.1, KEY_F1.3, KEY_F1.5, KEY_F2.1, KEY_F2.3, KEY_F2.5, KEY_F3.1, KEY_F3.3, KEY_F3.5, KEY_F4.1, KEY_F4.3, KEY_F4.5, KEY_F5.1, KEY_F5.3, KEY_F5.5
/Keypad/KEYPAD_ROW_G: IC1.35, KEY_G0.1, KEY_G0.3, KEY_G0.5, KEY_G1.1, KEY_G1.3, KEY_G1.5, KEY_G2.1, KEY_G2.3, KEY_G2.5, KEY_G3.1, KEY_G3.3, KEY_G3.5, KEY_G4.1, KEY_G4.3, KEY_G4.5, KEY_G5.1, KEY_G5.3, KEY_G5.5
/MCU/UART_CTS: IC3.11, R8.1
/MCU/UART_RTS: IC3.3, R7.1
/MCU/UART_RXD: IC3.1, R4.2, R5.2, R6.2
/MCU/UART_TXD: IC3.5, R3.2
/MCU/VUSB_SENSE: IC1.28, IC3.19, R11.2, R12.1
/UART/USBD+: CON3.3, IC3.15
/UART/USBD-: CON3.2, IC3.16
GND: BAT2.2, C1.2, C2.1, C3.2, C4.2, C8.2, C9.1, C10.1, C11.1, C12.1, C13.1, C15.2, C16.2, C17.2, C18.2, C19.2, C20.2, CON1.2, CON2.6, CON3.5, DISP1.26, DISP1.33, IC1.3, IC1.5, IC1.7, IC1.38, IC2.2, IC3.7, IC3.18, IC3.21, IC3.25, IC3.26, IC4.6, IC4.7, R10.1, R12.2, R14.1, SW1.1
unnamed: CON2.4, IC1.9
unnamed: LED1.2, R1.2
unnamed: CON2.1, IC1.8
unnamed: CON2.3, IC1.10
unnamed: CON1.1, IC1.12
unnamed: CON2.5, IC1.11
unnamed: LED2.2, R2.2
unnamed: IC1.23, R6.1
unnamed: IC1.40, R3.1
unnamed: IC1.6, LED2.1
unnamed: IC1.4, LED1.1
unnamed: CON1.4, IC1.1
unnamed: IC1.48, R8.2
unnamed: IC1.47, R7.2
unnamed: IC1.24, R5.1
unnamed: IC1.39, R4.1
unnamed: C10.2, DISP1.24
unnamed: C11.2, DISP1.23
unnamed: C12.2, DISP1.22
unnamed: C7.1, DISP1.31
unnamed: C5.2, DISP1.28
unnamed: C9.2, DISP1.25
unnamed: C13.2, DISP1.21
unnamed: C5.1, DISP1.27
unnamed: IC4.5, L2.2
unnamed: C6.1, DISP1.29
unnamed: C8.1, DISP1.32
unnamed: C6.2, C7.2, DISP1.30
unnamed: DISP1.18, DISP1.19, DISP1.20, IC4.2, LED4.2, LED5.2, LED6.2, LED7.2, LED8.2, LED9.2, LED10.2, LED11.2, LED12.2, LED13.2, LED14.2, LED15.2, LED16.2, LED17.2, LED18.2, LED19.2, LED20.2, LED21.2, R14.2
unnamed: C20.1, DISP1.1, DISP1.2, DISP1.3, IC4.4, LED4.1, LED5.1, LED6.1, LED7.1, LED8.1, LED9.1, LED10.1, LED11.1, LED12.1, LED13.1, LED14.1, LED15.1, LED16.1, LED17.1, LED18.1, LED19.1, LED20.1, LED21.1
unnamed: C15.1, CON3.1, FB1.1
unnamed: C18.1, IC3.4, IC3.17, R13.2
unnamed: LED3.1, R13.1
unnamed: IC3.13, LED3.2
unnamed: IC2.4, R9.2, R10.2
unnamed: IC2.1, L1.1
unnamed: BAT1.1, SW1.3
unnamed: BAT1.2, BAT2.1
VUSB: C16.1, C17.1, FB1.2, IC3.20, R11.1
