hotwolf/AriCalculator/(commit log)

2010-04-12 Added HSW12 assembler to tools
2010-04-13 Added S12CBase to subprojects
    [bdm_pod.brd, bdm_pod.sch]
2010-04-13 clean up
    [bdm_pod.brd, bdm_pod.sch]
2010-04-22 added functions to SCI driver
2010-04-29 added macros "PRINT_UPPER_B" and "PRINT_LOWER_B"
2010-07-08 Moved CF_NAME and CF_NUMBER into assembler subroutines
2010-07-08 Moved CF_HEADER into an assembler subroutine
2010-07-15 CASE statements are working
2010-07-15 Moved CF_FIND into an assembler subroutine
2010-07-29 Fixed PRINT_SINTCNT
2010-07-29 CASE is working again
2010-07-30 fixed PRINT
2010-11-05 BDM driver implemented
2010-11-08 BDM driver syntax checked
2011-01-07 Simplified SCI driver (untested
2011-01-09 Make use of SP register in PRINT
2012-02-20 Fixed XON/XOFF flow control
2012-02-23 BDM driver for LFBDMPGMR in progress
2012-02-25 Fixed forced flow control
2012-04-05 added RevB of the enclosure ans PCB design
2012-04-07 improved enclosure and board to simplify assembly
2012-04-13 added BOM
2012-04-23 fixed bugs in pn pcb, added SMD option for capacitors
2012-07-10 added hardware ports
    [bdm_pod.brd, bdm_pod.sch]
2012-08-10 switched to common clock driver
2012-11-15 reimplemented SCI driver
2012-11-15 fixes for the SCI driver
2013-01-08 fixing subprojects
    [bdm_pod.brd, bdm_pod.sch]
2013-01-09 debugged XON/XOFF flow control
2013-06-04 added initial NVM driver template for the Mini-BDM-Pod port
2013-06-13 implemented NVM drivers for all ports
2014-07-09 updated IO list for FreeEMS Jaguar board
2014-08-22 added keypad driver
2014-08-26 display driver is working
2014-09-19 updated RevB board design
2014-09-30 added VUSB monitor for RevB boards
2014-10-29 started RevC design
    [AriCalculator-RevC-Display.sch, AriCalculator-RevC-Keypad.sch, AriCalculator-RevC-MCU.sch, AriCalculator-RevC-Main.kicad_pcb, AriCalculator-RevC-Main.sch, AriCalculator-RevC-Supply.sch, AriCalculator-RevC-UART.sch]
2014-10-30 initial schematic done
2014-10-31 cleaned up schematic
    [AriCalculator-RevC-MCU.sch, AriCalculator-RevC-UART.sch, AriCalculator-RevC.kicad_pcb, AriCalculator-RevC.sch]
2014-11-03 work in progress
    [AriCalculator-RevC-Display.sch, AriCalculator-RevC-Keypad.sch, AriCalculator-RevC-MCU.sch, AriCalculator-RevC-Supply.sch, AriCalculator-RevC-UART.sch, AriCalculator-RevC.sch]
2014-11-03 added enclosure
2014-11-04 started RevC layout
    [AriCalculator-RevC-Display.sch, AriCalculator-RevC-Keypad.sch, AriCalculator-RevC-MCU.sch, AriCalculator-RevC-Supply.sch, AriCalculator-RevC-UART.sch, AriCalculator-RevC.kicad_pcb, AriCalculator-RevC.sch]
2014-12-15 clean-up ongoing
    [AriCalculator-RevC Laser Order.dxf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]
2015-01-04 fixed R9/R10 labels, fixed polarity of LEDs at PE0/PE1
    [AriCalculator-RevC-Display.sch, AriCalculator-RevC-Keypad.sch, AriCalculator-RevC-MCU.sch, AriCalculator-RevC-Supply.sch, AriCalculator-RevC-UART.sch, AriCalculator-RevC.sch]
2015-01-04 fixed front silkscreen (LED polarity at PE0/PE1)
    [AriCalculator-RevC-F_SilkS.gto]
2015-01-04 fixed front silkscreen (keypad coordinate G)
    [AriCalculator-RevC-F_SilkS.gto]
2015-01-04 updated schematic PDF
2015-01-05 fixed assembly plan
2015-04-02 fixed IO initialization for BEPM board
2015-06-04 added backlight driver
2015-10-15 IP now points to current instruction
2015-11-04 updated NVM drivers
2015-12-11 changed SPI TX status tracking
2016-01-14 moving towards subroutine threaded code
2016-06-23 updated TIM driver
2016-10-05 updated SCI driver
2016-11-08 CASE implemented
2016-11-08 CASE implementation fixed
2017-02-05 added printable case
    [case.scad]
2017-02-05 design improvements
    [case.scad]
2017-02-20 SCI driver debugged on Mini-BDM-Pod
2017-02-23 added 3D printable case
    [case.scad]
2017-04-03 Added button height
2017-07-07 improved case design
    [case.scad]
2017-07-10 initial reset driver
2017-08-14 updated case
    [case.scad]
2017-11-08 rearranged directory structure
    [AriCalculator-RevC-Display.sch, AriCalculator-RevC-Keypad.sch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]
2017-11-09 added Keypad PCB
    [Keypad.kicad_pcb, Keypad.sch]
2017-11-09 added Gerber files
    [Keypad-B.Cu.gbl, Keypad-B.Mask.gbs, Keypad-B.SilkS.gbo, Keypad-Edge.Cuts.gm1, Keypad-F.Cu.gtl, Keypad-F.Mask.gts, Keypad-F.SilkS.gto, Keypad.drl]
2017-12-17 fixed keypad PCBs
    [Keypad.kicad_pcb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]
2018-01-05 rewrote LCD display driver
2018-01-30 simplified SCI driver
