hotwolf/AriCalculator/(notices)

Notices in the files:
Hardware/RevC/Keypad/KiCad/Keypad.kicad_pcb:
CC BY-SA
